cong-or/blindsig-accel/blindsig-soc/doc/soc_arch.png

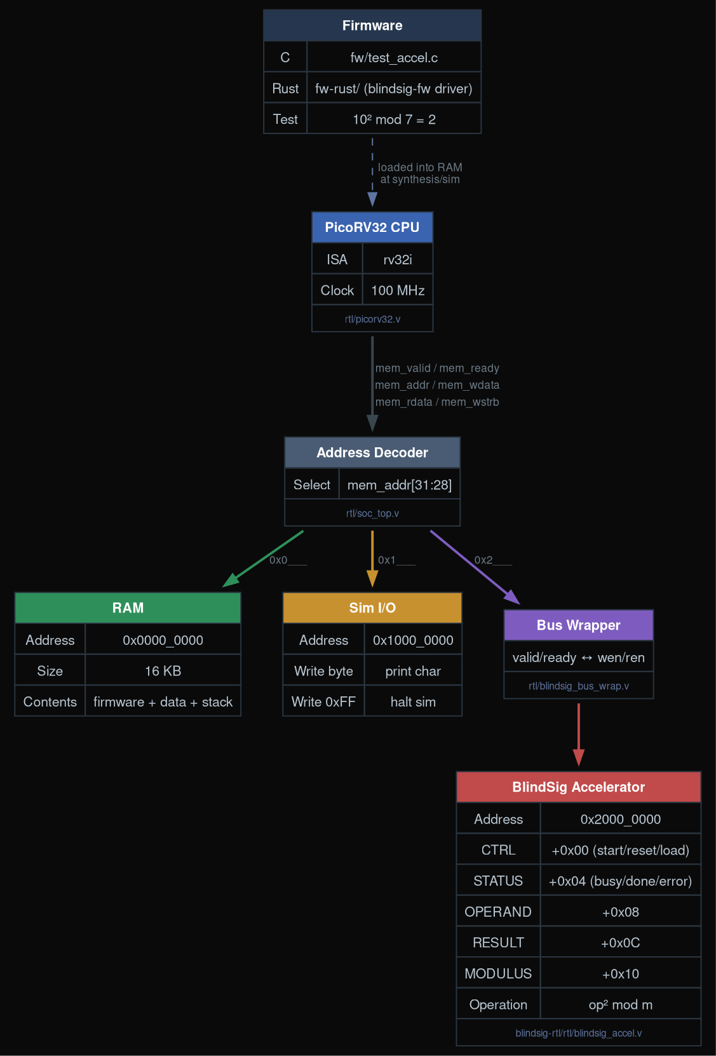
blindsig-soc/doc/soc_arch.png
