cong-or/blindsig-accel/(commit log)

2026-09-04 Blind signature accelerator RTL and PicoRV32 SoC integration
    Verilog accelerator peripheral with an MMIO register interface, wired into
    a PicoRV32 SoC and driven by C and Rust firmware. The arithmetic core does
    operand^2 mod modulus for now, as a placeholder while I build out the
    Montgomery multiplier and modexp pipeline for RSA and blind Schnorr.
    - blindsig-rtl: accelerator + self-checking testbench
    - blindsig-soc: PicoRV32 + accelerator, C and Rust firmware, sim testbench
    - blindsig-fw: no_std Rust MMIO driver
    RTL is CERN-OHL-P, firmware MIT/Apache-2.0. PicoRV32 is Claire Wolf's, ISC.
2026-09-04 Add constant-time modular multiplier and reducer; use them in the accelerator
    Replace the accelerator's operand^2 mod modulus, which leaned on Verilog's
    behavioural * and % operators, with two bit-serial constant-time datapaths:
    - mulmod.v: (a*b) mod m, MSB-first, fixed WIDTH-cycle latency, data-independent
    control (the reduce/add choices are muxes, not branches). tb_mulmod checks
    the latency is identical across all inputs, from 0 to (m-1)^2.
    - redmod.v: x mod m, same discipline, reduces the operand before multiplying.
    blindsig_accel now does redmod -> mulmod behind the same register interface.
    mulmod unit test 12/12; accelerator 4/4; SoC integration passes end-to-end.
    [blindsig_accel.v, mulmod.v, redmod.v, tb_mulmod.v]
2026-09-04 Formally verify the modular multiplier with SymbiYosys
    Add formal/mulmod.sby and an `ifdef FORMAL harness to mulmod.v:
    - invariant: unbounded k-induction proof that the accumulator stays reduced
    (acc < m) throughout the run, at the full 32-bit width.
    - equiv: exhaustive BMC proof that result == (a*b) mod m at a reduced width,
    against an independent reference.
    Both pass. 'make formal' runs them (requires SymbiYosys / OSS CAD Suite).
2026-09-05 Fix test.sh build, harden SoC elaboration, sharpen docs
    test.sh compiled only blindsig_accel.v (missing redmod.v/mulmod.v), so it
    failed to build against the current RTL, and its narration still described the
    old placeholder core (4-cycle, 64-bit intermediate, 'toy'). Rewrite it to build
    the full datapath, run the modular-multiplier unit test and the SymbiYosys
    proofs, and describe the real constant-time design.
    soc_top.v used simio_ready_r before its declaration; stricter Verilog front ends
    reject that. Declare it up front so the SoC elaborates on any toolchain.
    Docs: state that the multiplier reduces by conditional subtraction and that the
    funded work swaps in Montgomery reduction; note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
    [blindsig_accel.v, soc_top.v]
2026-09-05 Add live WASM demo, composability diagrams, and CI/Pages deploy
    web/: an interactive playground where the real mulmod.v — compiled to WebAssembly
    via Verilator + Emscripten — runs in the browser and drives an animated datapath,
    alongside a verification panel (simulate + prove), the interface contract, and
    copy-paste instantiation/driver snippets. Deep-navy blueprint design system on the
    self-hosted Space Grotesk/Mono.
    doc/: datapath and composability diagrams (SVG + PNG), embedded in the READMEs.
    CI: simulate (Icarus) and prove (SymbiYosys) the RTL, run the full CPU->bus->accel
    integration for both C and Rust firmware, then compile the WASM demo and publish it
    to GitHub Pages.
    READMEs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
2026-09-07 Spell out the prototype stand-ins and add a tiered roadmap
    Name the three deliberate substitutions (conditional-subtraction vs
    Montgomery, PicoRV32 vs VexRiscv, Icarus vs Verilator co-sim) so they can't
    be missed, and add a roadmap separating funded-grant work from the direction
    beyond it: side-channel hardening, reproducible supply-chain integrity, and
    an off-the-shelf catalogue of verified components for builders.
2026-09-07 Add a per-milestone done / not-done status table to the roadmap
    Key the roadmap to the proposal's five milestones with explicit
    partial/not-started status, so what the prototype actually delivers versus
    what the funded work still has to build is unambiguous. Prototype completes
    none of the five; the blind-signature operations themselves are still ahead.
2026-09-07 Fix CI: correct moved/stale action refs and decouple demo deploy
    - setup-emsdk moved from mymindstorm to emscripten-core (Actions does not
    reliably follow the transfer redirect, which failed the demo build)
    - bump setup-oss-cad-suite v3 -> v4
    - deploy the live demo from the committed web/ assets, gated only on the RTL
    passing, so an Emscripten/Verilator rebuild hiccup no longer takes the site
    offline; keep the WASM rebuild as an independent buildability check
2026-09-07 Drive the demo animation from the real circuit, not a JS re-derivation
    Expose the datapath's active b bit (b_reg MSB) from the Verilated model and
    use it to light the pipeline stages, instead of recomputing the bit schedule
    in JavaScript. The result, accumulator, cycle count and now the animation all
    come from the compiled mulmod.v — verified in node: the b-bits read back from
    b_reg match b's binary exactly, result correct in 33 cycles.
2026-09-07 Reroute the datapath diagram with clean orthogonal traces
    Replace the crossing bezier fan-in/feedback curves with right-angle traces:
    a_reg -> +a along the top, the modulus bus into both reducers, and a single
    tidy acc -> x2 feedback loop clear of the legend. Also more faithful to the
    recurrence (x2 is driven by the feedback, not a register). Unify the standalone
    doc/ and web/assets copies to this same layout and re-render the PNG.
2026-09-07 Redesign the demo to match blindsig-hardware.org: simpler, less salesy
    Rebuild the playground in the project site's design language — near-black
    background, teal accent, narrow single column, small type, lowercase section
    heads. Strip the marketing scaffolding (hero, CTA buttons, feature cards,
    'aerospace-grade', compose section) down to: what it is, the live circuit, how
    to run it, interface + license. Retheme the datapath SVG and its animation from
    navy/cyan to the site's black/teal, and re-sync the standalone copies.
2026-09-07 Add release workflow: publish a GitHub release on v* tags
    Uses the repository's own GITHUB_TOKEN (github-actions[bot]) to create the
    release from the annotated tag — no personal credentials, no external identity.
2026-09-07 Demo: cockpit-grade annunciator panel (Airbus cognitive-load discipline)
    Add a fixed annunciator strip under the schematic — a single STATE indicator
    (STANDBY/READY/RUN/DONE/FAULT), a bounded 33-segment SEQUENCE gauge, and the
    primary RESULT readout — with a strict color grammar (dim standby, teal engaged,
    brighter teal done, red fault) and a terse ECAM-style status memo. Dark-cockpit
    resting state, segmented panel zones, spatial progress over raw numbers.
2026-09-07 README: move 'Why this matters' to the end as the closer
    Pure reorder — vision now follows the concrete sections (status, roadmap, use,
    verify) instead of interrupting the what-is-it flow. Fixed the one relative
    reference (below -> above) since 'What's guaranteed' now precedes it.
2026-09-07 Demo: make it obvious this is the real RTL, not a toy
    Add a provenance bar on the instrument (mulmod.v -> Verilator -> WebAssembly,
    readouts live from the circuit's registers, plus an 'inspect the harness' link),
    strengthen the intro to state it's the exact synthesised logic and every result
    is cross-checked, and retitle the section 'the real circuit, live'.
2026-09-07 Add .gitattributes so language stats reflect the project's own code
    Mark the generated Emscripten glue (web/wasm/*) and the vendored PicoRV32 core
    as such, so the repo reads as the RTL/firmware project it is.
2026-09-07 Add CITATION.cff so the project is citeable
    Enables GitHub's 'Cite this repository' button; records authorship, version,
    license set, and keywords.
2026-09-07 Comments: add a plain-English gloss to each module; document the Rust driver
    Give every core module a one-line 'in plain terms' explanation so a non-RTL
    reader can follow what it does, without touching the (formally-verified) logic.
    Add the missing crate-level doc + usage example to the no_std driver and drop a
    stray blank line. Full test + formal suite still passes.
    [blindsig_accel.v, blindsig_bus_wrap.v, mulmod.v, redmod.v, soc_top.v]
2026-09-07 README: calm, professional editorial pass
    Cut heavy bold to list-item labels only, drop status emoji for plain words,
    ease the punctuation, shorten lines and add breathing room. Same content and
    honesty, quieter surface.
2026-09-07 Emphasise side-channel resistance and the verified-component catalogue
    Frame constant-time explicitly as timing side-channel resistance in What's
    proven, and rebuild Why it matters around the two strongest hooks: side channels
    designed out (timing today, power/EM under the grant) and a catalogue of
    formally-verified, permissively-licensed building blocks others can drop in.
2026-09-07 Make the early-prototype status unmistakable up top
    Add a prominent note at the top of the README: early feasibility prototype, the
    blind-signature operations are not built yet, completes none of the five funded
    milestones, and the bulk of the work is what the grant funds. Frames the
    existing work as feasibility/capability, not a finished product.
2026-09-08 Make the demo unmistakably a simulation
    Frame the live panel as a see-through clock, state plainly there is no
    physical chip in the browser, and stop calling the Verilator model
    'synthesised' — synthesis to FPGA is future (grant) work, not what runs here.
2026-09-08 Add a pedagogical layer to the mulmod demo
    - Show b consumed one bit per clock, live from the circuit: expose b_reg
    from the Verilator harness and rebuild the committed WASM.
    - Add a 'Prove it' button that runs four very different inputs and shows
    they all finish on the same cycle.
    - Add a schematic timing contrast (branchy software vs fixed datapath), a
    plain-language legend, a hex accumulator, and a scope note that this is
    the core multiplier, not the finished accelerator.
    - Link the formally-verified badge to the proofs.
2026-09-08 Tighten the demo copy to a professional register
    Replace the casual, metaphor-heavy wording (gears, 'behind glass', 'branchy',
    'wildly different', 'the whole point') with precise language, and rename the
    empirical 'Constant-time proof' panel to a 'demonstration' — the SymbiYosys
    check is the proof. Keeps the design system and one restrained see-through
    reference.
2026-09-08 Correct and professionalise repo code + copy
    - test.sh: the reducer is tested, not formally proven — only the multiplier
    carries the SymbiYosys harness. Correct the results summary accordingly.
    - blindsig-fw: export BLINDSIG_BASE (previously an unused private const that
    emitted a dead-code warning); document it and use it in the doc example.
    - CITATION.cff: bump version to the latest release (0.1.2).
    - mulmod.v: minor comment wording.
    [mulmod.v]
2026-09-08 Frame the verified-building-block pipeline as the core value
    Expand README 'Why it matters' into the method-is-the-deliverable thesis:
    correctness that travels with the artifact as a re-runnable proof, with the
    rise of tool- and agent-generated RTL as the amplifier (not the foundation),
    scoped to open cryptographic hardware. Echo one line in ROADMAP.
2026-09-08 Refine demo + README UX (cockpit discipline, cognitive load, a11y)
    From a multi-lens audit (7 reviewers, adversarially verified): 25 changes kept,
    8 rejected. All HTML/CSS/JS/Markdown — no RTL or WASM change.
    Cockpit/ECAM: acc box glows only while computing (was always-on); calm the
    header dot (no infinite pulse); mute the static provenance pills so only live
    state carries saturated teal.
    Cognitive load: lede + instrument first, exposition moved to a 'how it works'
    section below; real heading hierarchy; explain 33 = 1 load + 32 steps; relabel
    the timing contrast so it cannot read as 'hardware is slower'.
    Accessibility: raise --dim to WCAG AA; focus-visible rings; role=img + title/desc
    on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
2026-09-08 Refine README from a second UX audit
    Multi-lens audit, adversarially verified: 7 changes kept, 3 rejected.
    - What's proven: constant-time is asserted by the testbench (tb/tb_mulmod.v),
    not the SymbiYosys proofs — attribute it correctly and split the re-run
    instructions (make formal for the proofs, make for the constant-time check).
    - Quick start: add SymbiYosys to the prerequisites (make formal needs it) and
    make the block paste-safe from a fresh clone (git clone + make -C).
    - Status: note the packaged accelerator computes operand² today while the
    general (a·b) mod m core exists; tighten the opening.
    - Lede leads with the real artifact (verified mulmod.v) before the larger goal.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
2026-09-08 Declare blindsig-fw crate license (MIT OR Apache-2.0)
    Add license, description and repository to Cargo.toml so the 'permissively
    licensed, drop it in' claim holds for anyone vendoring just the driver crate,
    and so it is publish-ready.
2026-09-08 Tighten README/ROADMAP wording; fix two toolchain overstatements
    Editorial pass on the overview and roadmap prose (shorter, plainer). Correct two
    inaccuracies: FPGA synthesis is future work, so drop 'synthesised with a fully
    open flow'; and nextpnr is not part of the flow that runs today, so remove it
    from the demo toolchain line. Drop the exploratory VISION note; its point is
    covered under ROADMAP 'Beyond the grant'.
2026-09-08 Sub-READMEs: add a 'three parts' orientation; fix a stale line
    Each of blindsig-rtl / -soc / -fw now states where it sits in the repo and
    links the other two, so a reader landing in any directory is oriented. Also
    corrects blindsig-rtl's testbench description (it checks a range of operands up
    to (m-1)^2, not every case).
2026-09-09 README + demo: lead with the use case, tighten the proof claims
    - README: open with what blind signatures are and who they're for (Taler,
    Cashu, Fedimint, offline Digital Euro); match the project title; hoist the
    datapath diagram to the top; add a reusable-modules section. Scope the formal
    claims — correctness proven exhaustively at reduced width, range invariant at
    full 32-bit — and drop the "what it does not leak" wording (constant-time is a
    testbench check, not a proof). Surface the CI matrix; state the prototype
    status once and pivot to what it de-risks.
    - demo: name the project in the title/meta/subtitle; add the payments framing
    and a plain definition; promote and aut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
2026-09-09 demo: cut the visual noise, one home per value
    - Restrict teal to live readouts (cycle/acc/result) and lit state; demote
    static chrome (provenance line, inputs, section heads, register table) to
    grey, so "teal = live right now" actually reads.
    - Steady glow instead of a per-step strobe: drop the pulseAcc flashes, grey the
    accumulator box at rest.
    - Remove duplicate readouts: delete the annunciator (its progress bar and result
    mirrored the SVG) and the second accumulator; fold the STATE word into the
    b-register strip. Cycle now shows once, result twice (headline + cross-check).
    - Trim the datapath: drop the slogan band, the redundant "33 cycles" pill, the
    result banner and the rep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
2026-09-09 README: demote the AI-use disclosure to a footnote
    Keep the required GenAI disclosure in the README (policy) but drop the
    section header; it reads as fine print at the end rather than a heading.
2026-09-09 demo: legibility + tighter datapath; language stats read hardware-first
    - Bump contrast/size on the small uppercase labels (were low-contrast and
    hard to scan); lift the schematic note from dim to ink.
    - Shorten the comparison label (the explanation already follows below it).
    - Trim the datapath viewBox 560->500 so the interactive controls and the
    constant-time proof sit higher.
    - .gitattributes: mark web/ and doc/ as documentation so the language bar
    reflects the RTL/firmware, not the demo.
