cong-or/blindsig-accel/(notices)

Notices in the files:
README.md:
License: CERN-OHL-P, MIT/Apache-2.0
